aidanhiggs-embeddedwizard/EIT-Burn-detection/EIT Device/iEITBacon_Too_schematic.pdf

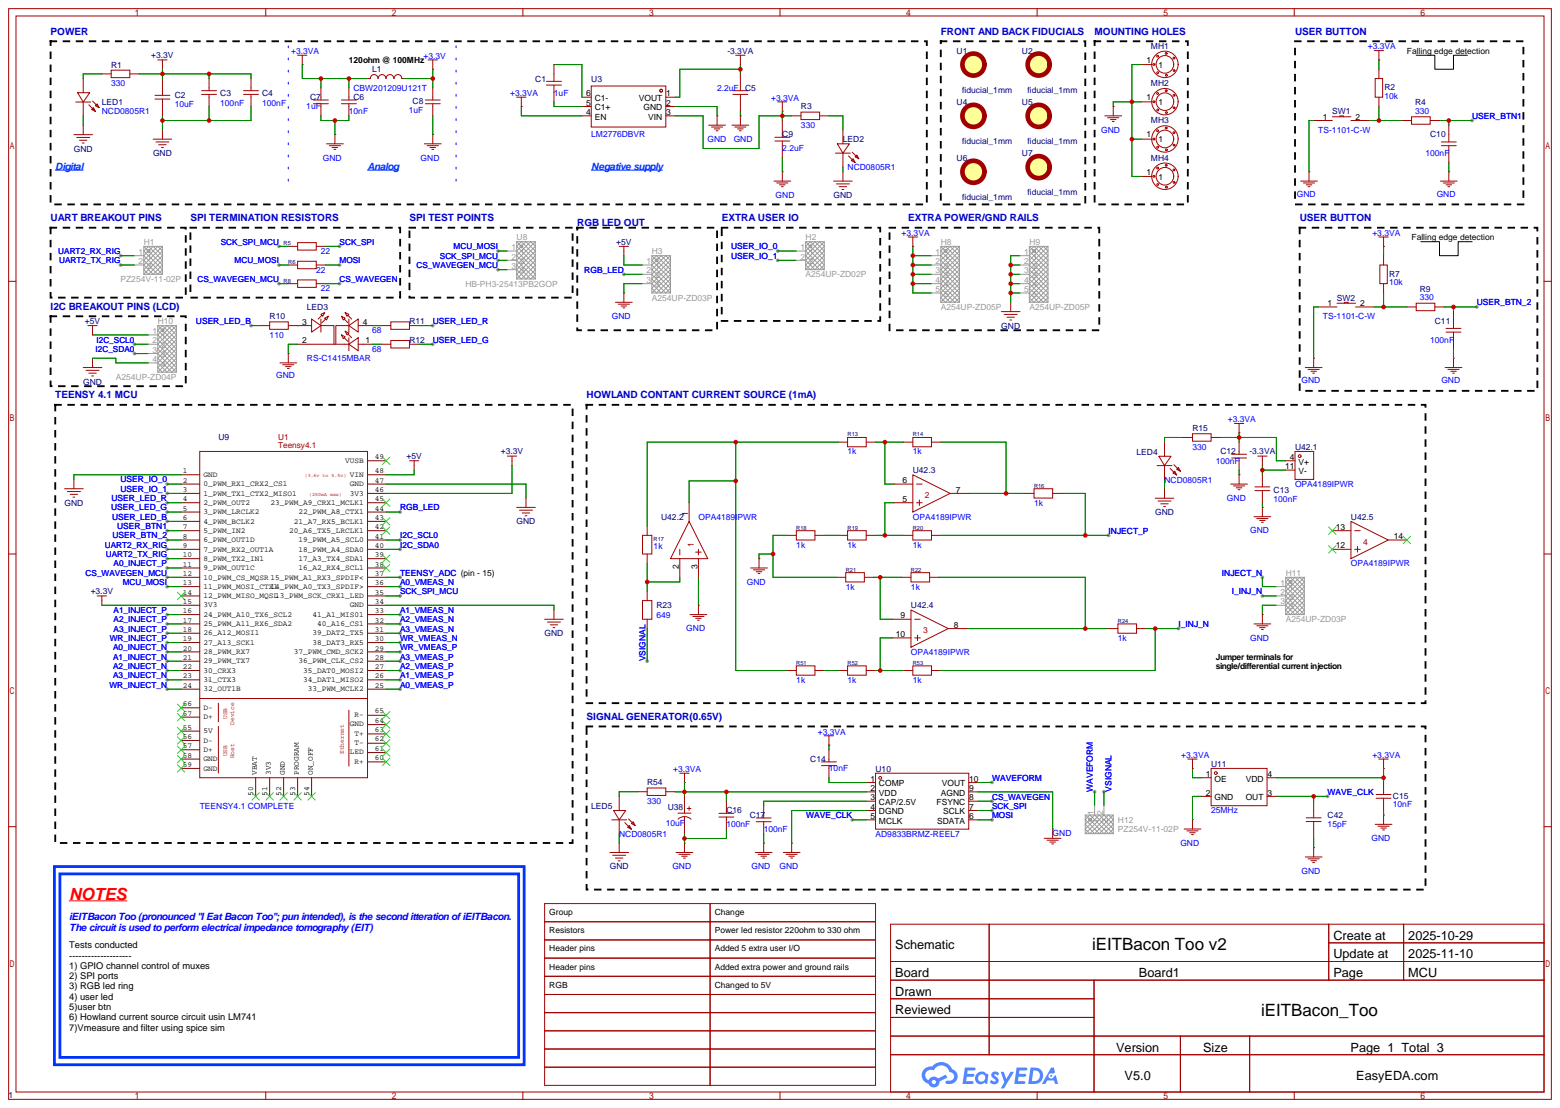
[picture p1: page 1]

FRONT AND BACK FIDUCIALS

EXTRA POWER/GND RAILS

Jumper terminals for
single/differential current injection

iEITBacon Too (pronounced "I Eat Bacon Too"; pun intended), is the second itteration of iEITBacon.
The circuit is used to perform electrical impedance tomography (EIT)
Tests conducted
1) GPIO channel control of muxes
2) SPI ports
3) RGB led ring
4) user led
5)user btn
6) Howland current source circuit usin LM741
7)Vmeasure and filter using spice sim

RGB | Changed to 5V

Drawn | iEITBacon_Too
Reviewed

Version | Size | Page 1 Total 3
V5.0 | | EasyEDA.com

# S17 25 S18 26 S19 27 S20 28 S21 29 S22 30 S23 31 S24 32 S25 33 S26 34 S27 35 S28 36

# S17 25 S18 26 S19 27 S20 28 S21 29 S22 30 S23 31 S24 32 S25 33 S26 34 S27 35 S28 36

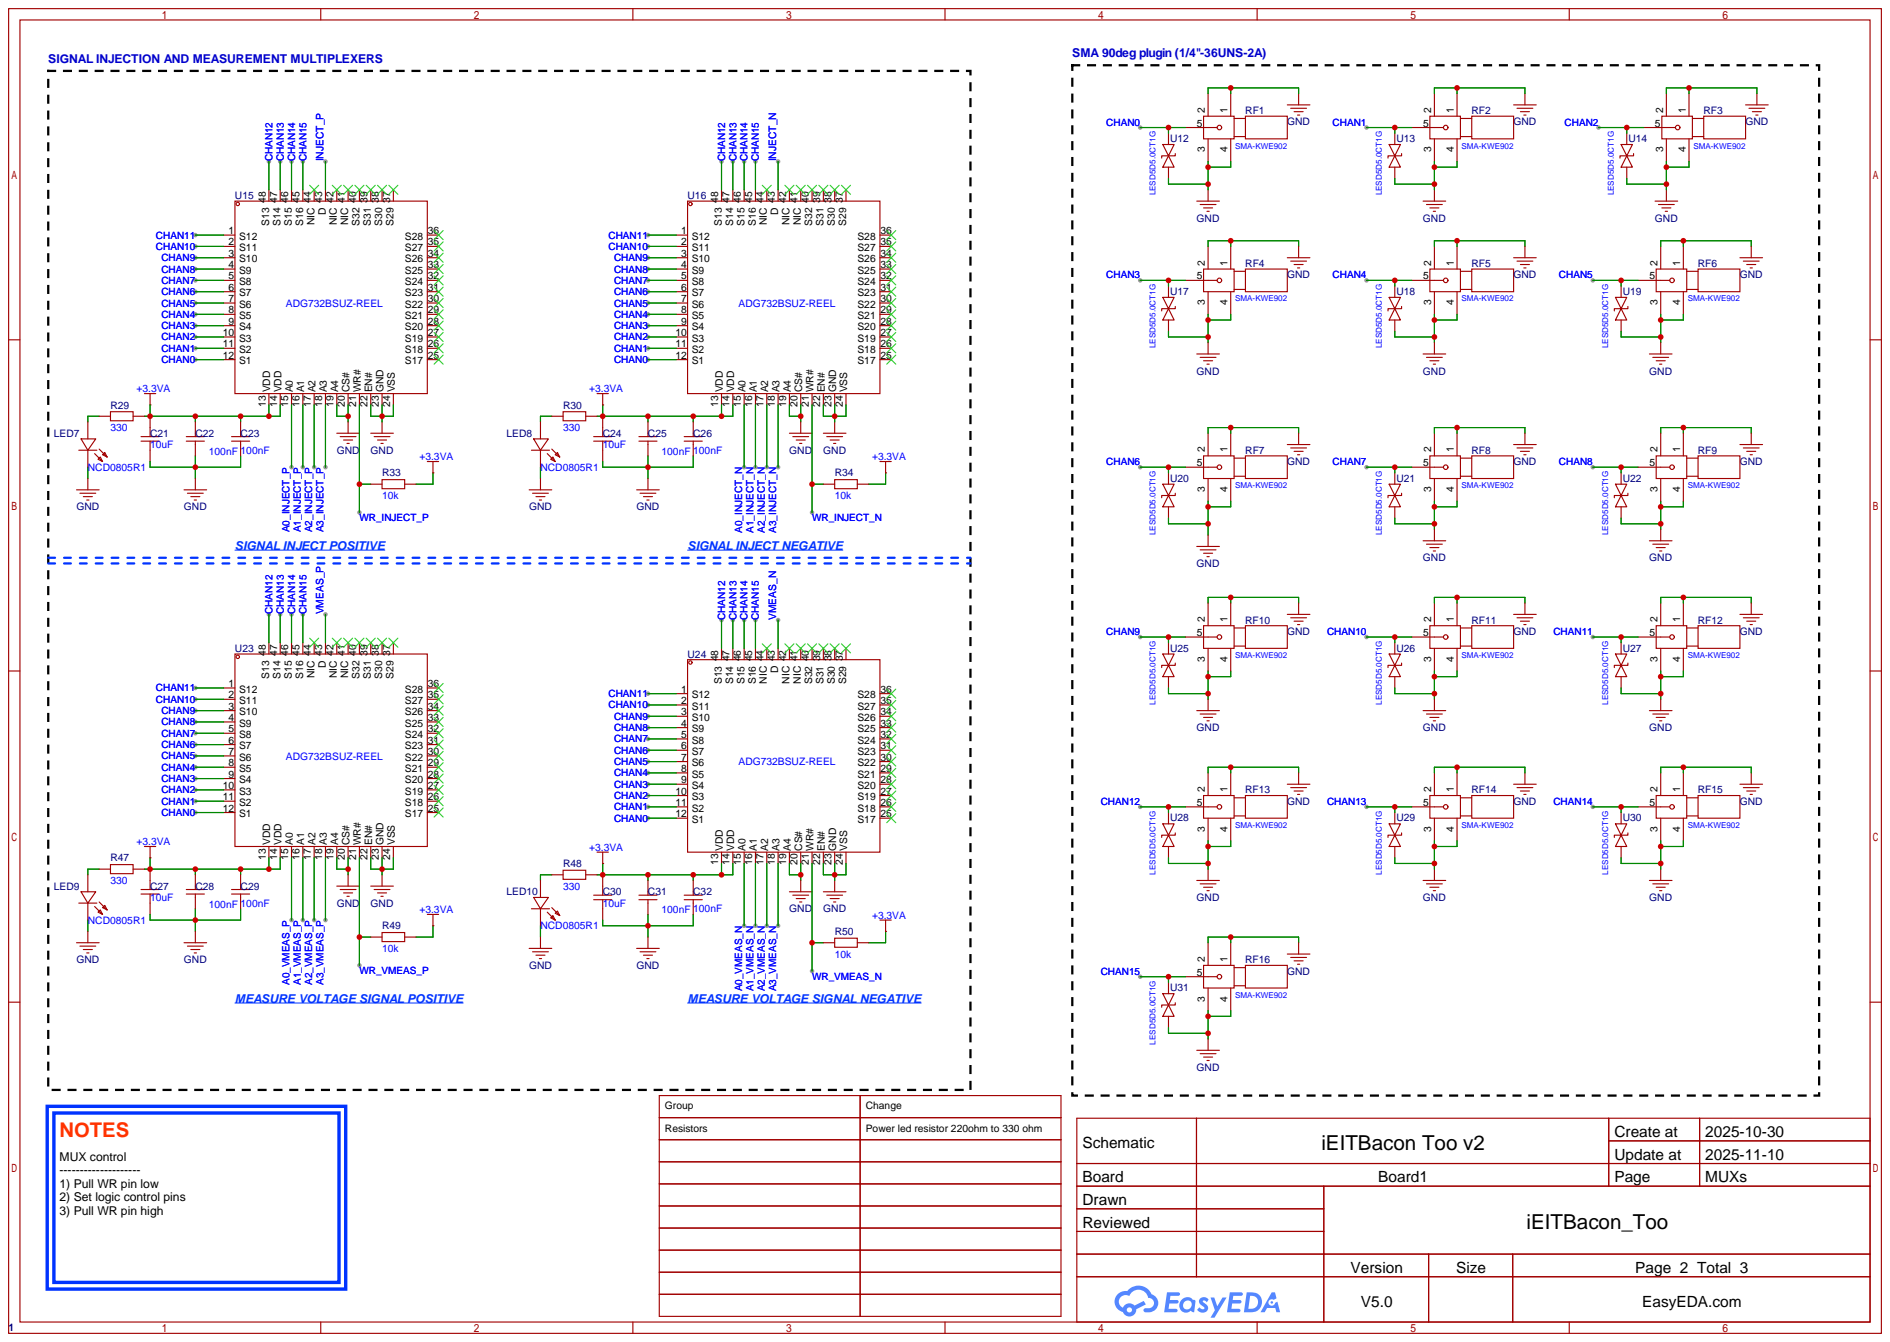
[picture p2: page 2]

SIGNAL INJECTION AND MEASUREMENT MULTIPLEXERS

Group | Change

Schematic | iEITBacon Too v2 | Create at | 2025-10-30

MUX control
1) Pull WR pin low
2) Set logic control pins
3) Pull WR pin high

Update at | 2025-11-10

Board | Board1 | Page | MUXs
Drawn | | iEITBacon_Too
Reviewed

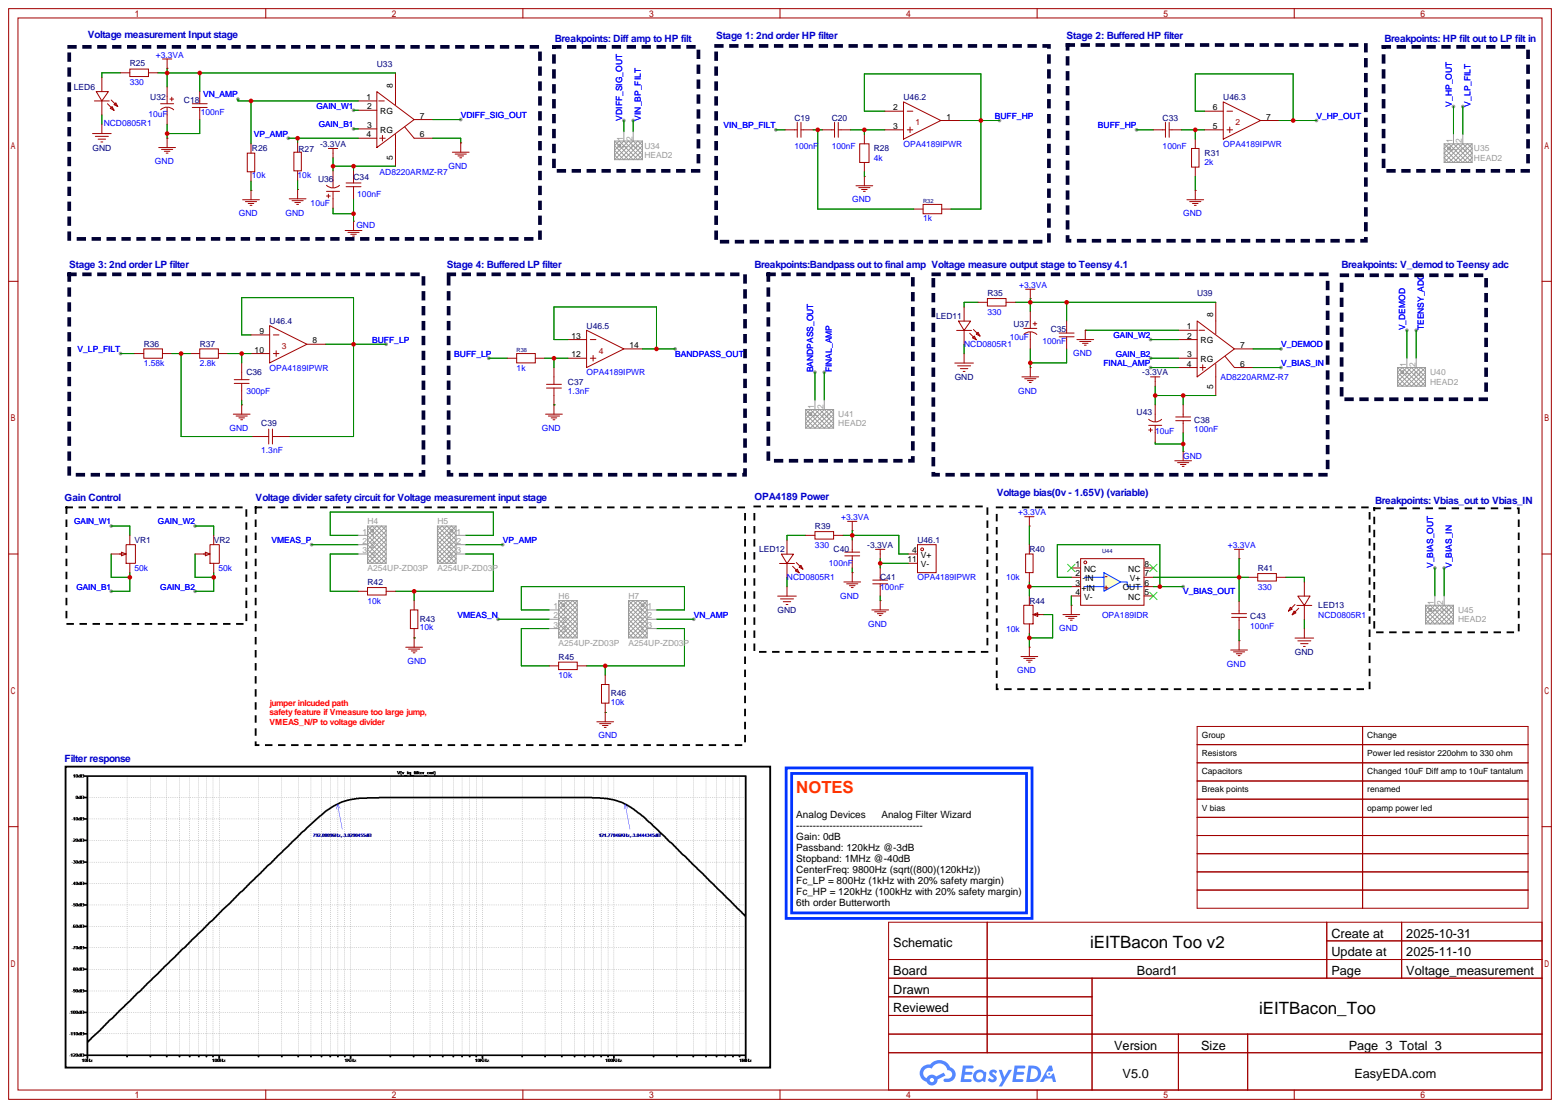
[picture p3: page 3]

Voltage measurement Input stage

Stage 1: 2nd order HP filter

Stage 2: Buffered HP filter

Stage 3: 2nd order LP filter

Stage 4: Buffered LP filter

Voltage measure output stage to Teensy 4.1

Voltage divider safety circuit for Voltage measurement input stage

jumper inlcuded path
safety feature if Vmeasure too large jump,
VMEAS_N/P to voltage divider

Group | Change
Resistors | Power led resistor 220ohm to 330 ohm
Capacitors | Changed 10uF Diff amp to 10uF tantalum
Break points | renamed
V bias | opamp power led

Analog Devices Analog Filter Wizard
Gain: 0dB
Passband: 120kHz @-3dB
Stopband: 1MHz @-40dB
CenterFreq: 9800Hz (sqrt((800)(120kHz))
Fc_LP = 800Hz (1kHz with 20% safety margin)
Fc_HP = 120kHz (100kHz with 20% safety margin)
6th order Butterworth

Schematic | iEITBacon Too v2 | Create at | 2025-10-31

Update at | 2025-11-10

Board | Board1 | Page | Voltage_measurement
Drawn | | iEITBacon_Too
Reviewed
