aidanhiggs-embeddedwizard/EIT-Burn-detection/(commit log)

2026-05-03 Expand README with device and test information
    Added sections for device and testing methods.
2026-05-03 Enhance README with device details and components
    Expanded the README.md to include detailed descriptions of the iEITBacon device and the Baconator burn wound device components.
2026-05-03 Fix grammar and enhance PID controller explanation
    Corrected grammar and added details about PID values and transfer function calculation.
2026-05-03 Improve README with transfer function details and reference
    Clarified the derivation of the transfer function and added a reference to Brian Douglas's video for PID controller design.
2026-05-03 Revise README with device details and dependencies
    Updated device description and added program dependencies section in README.md.
2026-05-03 Fix formatting and clarify Teensy DMA usage
    Corrected formatting of equations and clarified DMA usage.
